bristol-communal-modular/basic-theremin/build/parts-guide.png

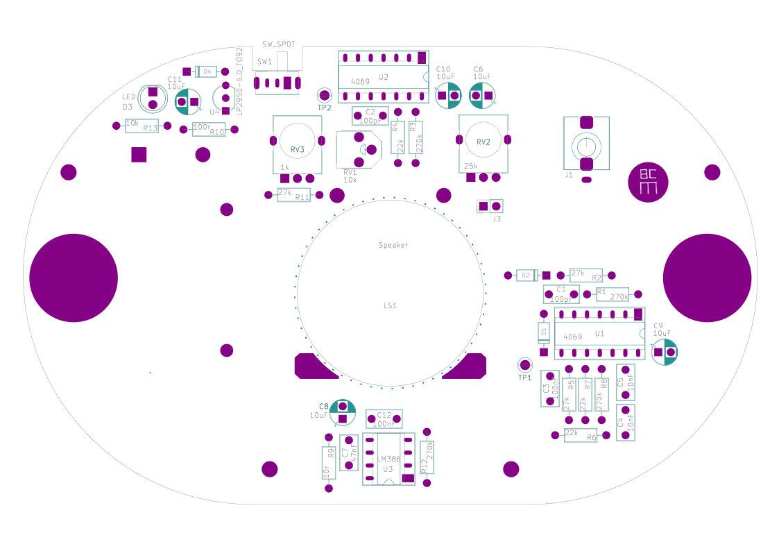
build/parts-guide.png
