bristol-communal-modular/basic-theremin/build/clara-bom.pdf

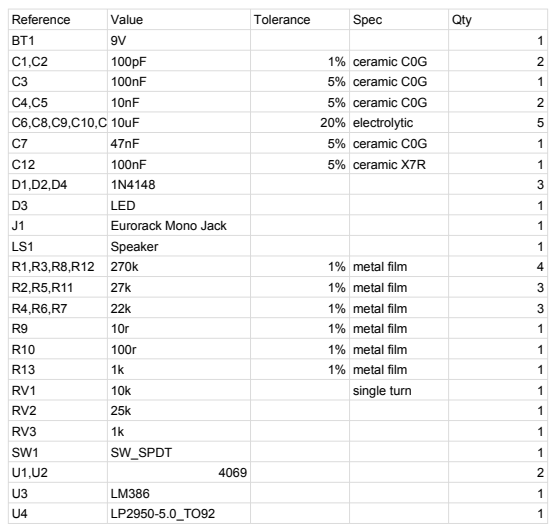
[picture p2: page 1]
