bristol-communal-modular/basic-theremin/build/schematic.pdf

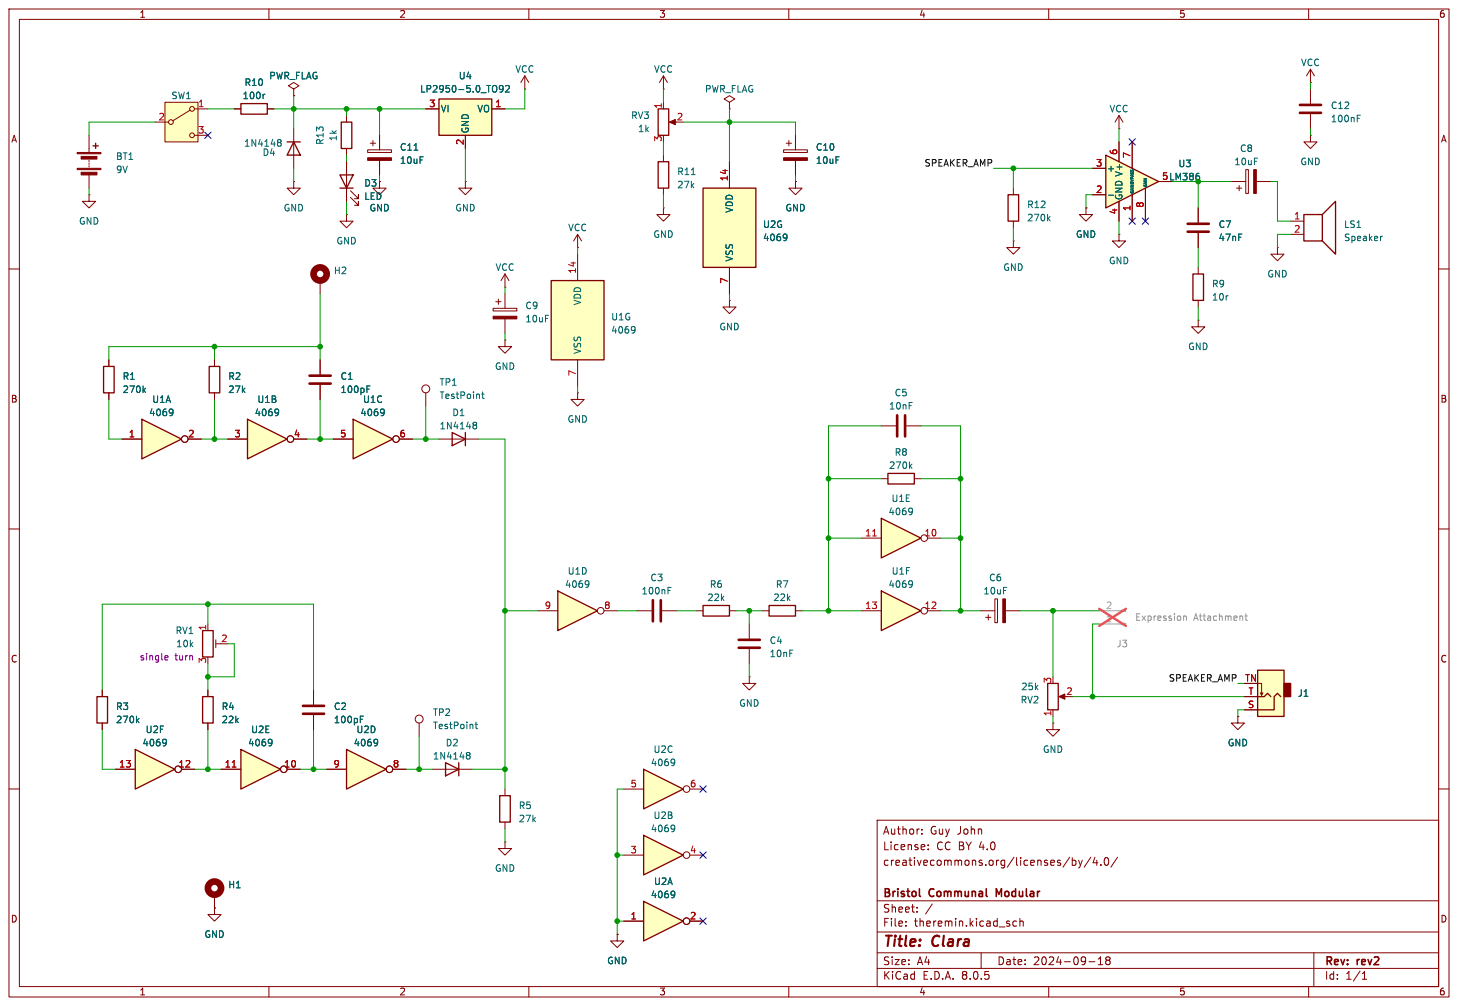
[picture p3: page 1]
