bristol-communal-modular/basic-theremin/kicad/theremin.kicad_pcb

## KiCad design kicad/theremin.kicad_pcb (2024-09-22)

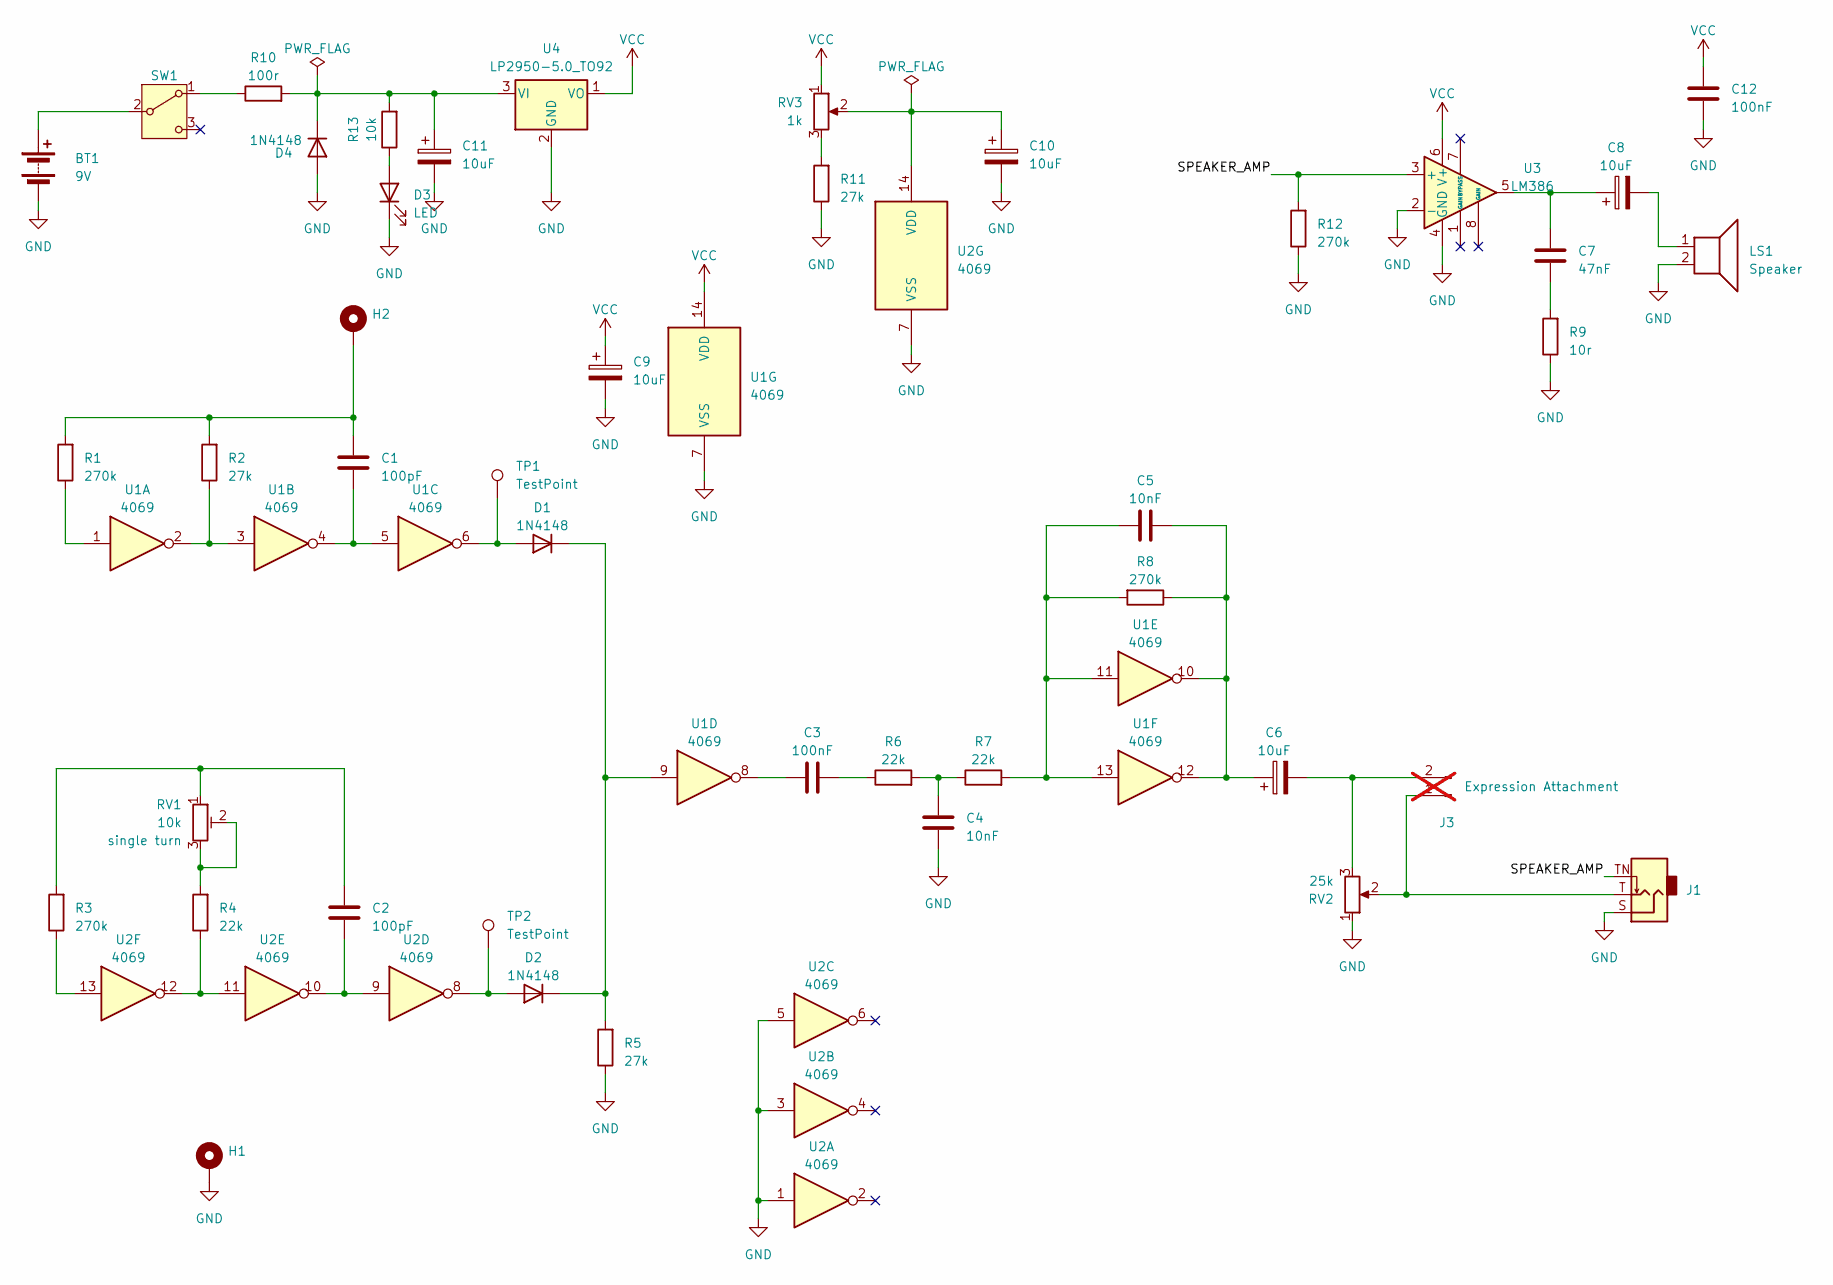
[picture p4: schematic theremin.kicad_sch, Clara]

Parts:
BT1: 9V; BatteryHolder_Eagle_12BH611-GRMODDEDBYROBIN
C1, C2: 100pF; C_Rect_L7.0mm_W3.5mm_P5.00mm; Tolerance 1%
C3, C12: 100nF; C_Rect_L7.0mm_W3.5mm_P5.00mm; Tolerance 5%
C4, C5: 10nF; C_Rect_L7.0mm_W3.5mm_P5.00mm; Tolerance 5%
C6, C8, C9, C10, C11: 10uF; CP_Radial_D5.0mm_P2.50mm; Tolerance 20%; Voltage 50v
C7: 47nF; C_Rect_L7.0mm_W3.5mm_P5.00mm; Tolerance 5%
D1, D2, D4: 1N4148; D_DO-35_SOD27_P7.62mm_Horizontal
D3: LED; LED_D5.0mm
H1, H2: MountingHole_Pad; crocclipcircleee
J1: Eurorack Mono Jack; Jack_3.5mm_QingPu_WQP-PJ398SM_Vertical; mpn WQP-WQP518MA
J3: Expression Attachment; PinHeader_1x02_P2.54mm_Vertical; not fitted
LS1: Speaker; 40mmSpeakerdropin
R1, R3, R8, R12: 270k; R_Axial_DIN0207_L6.3mm_D2.5mm_P10.16mm_Horizontal; Tolerance 1%
R2, R5, R11: 27k; R_Axial_DIN0207_L6.3mm_D2.5mm_P10.16mm_Horizontal; Tolerance 1%
R4, R6, R7: 22k; R_Axial_DIN0207_L6.3mm_D2.5mm_P10.16mm_Horizontal; Tolerance 1%
R9: 10r; R_Axial_DIN0207_L6.3mm_D2.5mm_P10.16mm_Horizontal; Tolerance 1%
R10: 100r; R_Axial_DIN0207_L6.3mm_D2.5mm_P10.16mm_Horizontal; Tolerance 1%
R13: 10k; R_Axial_DIN0207_L6.3mm_D2.5mm_P10.16mm_Horizontal; Tolerance 1%
RV1: 10k; Potentiometer_THT_Bourns_3306P_Vertical
RV2: 25k; Potentiometer_Alpha_RD901F-40-00D_Single_Vertical
RV3: 1k; Potentiometer_Alpha_RD901F-40-00D_Single_Vertical
SW1: SW_SPDT; SW_Slide_SPDT_Angled_CK_OS102011MA1Q
TP1, TP2: TestPoint; TestPoint_Loop_D2.50mm_Drill1.0mm_LowProfile
U1, U2: 4069; DIP-14_W7.62mm_Socket_LongPads
U3: LM386; DIP-8_W7.62mm_Socket_LongPads
U4: LP2950-5.0_TO92; TO-92_Inline_Wide

Connections:
/SPEAKER_AMP: J1.TN, R12.2, U3.3 (+)
GND: BT1.2 (-), C4.1, C9.2, C10.2, C11.2, C12.2, D3.1 (K), D4.2 (A), H1.1, J1.S, LS1.2, R5.1, R9.1, R11.1, R12.1, RV2.1, U1.7 (VSS), U2.1, U2.3, U2.5, U2.7 (VSS), U3.2 (-), U3.4 (GND), U4.2 (GND)
unnamed: BT1.1 (+), SW1.2 (B)
unnamed: C1.1, U1.4, U1.5
unnamed: C1.2, H2.1, R1.2, R2.2
unnamed: C2.1, U2.9, U2.10
unnamed: C2.2, R3.2, RV1.1
unnamed: C3.1, U1.8
unnamed: C3.2, R6.1
unnamed: C4.2, R6.2, R7.1
unnamed: C5.1, C6.1, R8.1, U1.10, U1.12
unnamed: C5.2, R7.2, R8.2, U1.11, U1.13
unnamed: C7.1, R9.2
unnamed: C7.2, C8.1, U3.5
unnamed: C8.2, LS1.1
unnamed: D1.2 (A), TP1.1, U1.6
unnamed: D1.1 (K), D2.1 (K), R5.2, U1.9
unnamed: D2.2 (A), TP2.1, U2.8
unnamed: D3.2 (A), R13.1
unnamed: C11.1, D4.1 (K), R10.2, R13.2, U4.3 (VI)
unnamed: J1.T, J3.1, RV2.2
unnamed: C6.2, J3.2, RV2.3
unnamed: R1.1, U1.1
unnamed: R2.1, U1.2, U1.3
unnamed: R3.1, U2.13
unnamed: R4.1, U2.11, U2.12
unnamed: R4.2, RV1.2, RV1.3
unnamed: R11.2, RV3.3
unnamed: R10.1, SW1.1 (A)
unnamed: C10.1, RV3.2, U2.14 (VDD)
VCC: C9.1, C12.1, RV3.1, U1.14 (VDD), U3.6 (V+), U4.1 (VO)

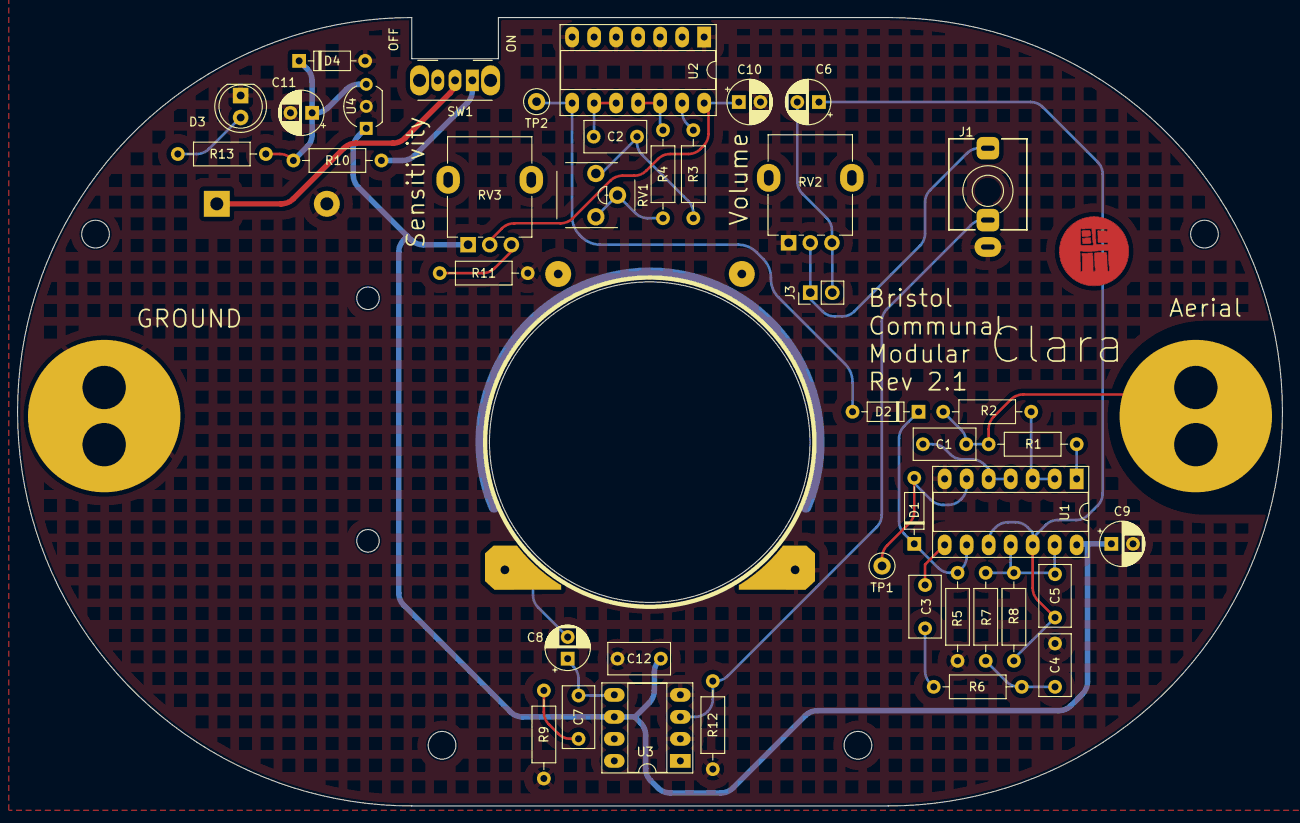
[picture p5: board theremin.kicad_pcb from above]

Board: 2 copper layers, 146.0 x 91.0 mm, 49 parts (1 on the bottom side), 31 nets.

Other parts of the board:
EF**: MountingHole_3.2mm_M3
EF**#2, EF**#3, EF**#4: MountingHole_3.2mm_M3
