bristol-communal-modular/basic-theremin/(commit log)

2024-06-19 Updating with new footprints and some tweaks
    [theremin.kicad_pcb, theremin.kicad_sch]
2024-06-30 Now with extra pretty!
    Added the updated prettiefied version of the theremin files and added some quality of life features such as battery clip, crocodile clip friendly connectors, built in speaker & a power switch
    [theremin-B_Cu.gbl, theremin-B_Mask.gbs, theremin-B_Silkscreen.gbo, theremin-Edge_Cuts.gm1, theremin-F_Cu.gtl, theremin-F_Mask.gts, theremin-F_Silkscreen.gto, theremin-NPTH.drl]
2024-07-02 Tidying things up a bit
    [theremin-B_Cu.gbl, theremin-B_Mask.gbs, theremin-B_Silkscreen.gbo, theremin-Edge_Cuts.gm1, theremin-F_Cu.gtl, theremin-F_Mask.gts, theremin-F_Silkscreen.gto, theremin-NPTH.drl]
2024-07-03 More updates
    [theremin-B_Cu.gbl, theremin-B_Mask.gbs, theremin-B_Silkscreen.gbo, theremin-Edge_Cuts.gm1, theremin-F_Cu.gtl, theremin-F_Mask.gts, theremin-F_Silkscreen.gto, theremin-NPTH.drl]
2024-07-03 More tweaks
    [theremin.kicad_sch]
2024-07-03 Regenerating gerbers
    [theremin-B_Cu.gbl, theremin-B_Mask.gbs, theremin-B_Silkscreen.gbo, theremin-Edge_Cuts.gm1, theremin-F_Cu.gtl, theremin-F_Mask.gts, theremin-F_Silkscreen.gto, theremin-NPTH.drl]
2024-07-04 Final tweaks to make sure the front plate holes are on grid
    [theremin-B_Cu.gbl, theremin-B_Mask.gbs, theremin-B_Silkscreen.gbo, theremin-Edge_Cuts.gm1, theremin-F_Cu.gtl, theremin-F_Mask.gts, theremin-F_Silkscreen.gto, theremin-NPTH.drl]
2024-07-22 Adding interactive bom
2024-09-18 Fixing issues with layout
    * Making sure speaker fixing copper isn't covered on speaker footprint
    * Adding two more plated holes to make fixing speaker easier
    * Making holes for battery holder smaller so easier to solder
    * Adding another mounting hole for faceplate
    * Tweaking value and reference text placements
    [theremin.kicad_pcb, theremin.kicad_sch]
2024-09-18 Adding schematic page text
    [theremin.kicad_sch]
2024-09-18 Adding updated gerbers
    [theremin-B_Cu.gbl, theremin-B_Mask.gbs, theremin-B_Silkscreen.gbo, theremin-Edge_Cuts.gm1, theremin-F_Cu.gtl, theremin-F_Mask.gts, theremin-F_Silkscreen.gto, theremin-NPTH.drl]
2024-09-18 Adding schematic to build directory
2024-09-18 Updating interactive bom
2024-09-18 Adding testpoints at output of oscillators
    [theremin-B_Cu.gbl, theremin-B_Mask.gbs, theremin-B_Silkscreen.gbo, theremin-Edge_Cuts.gm1, theremin-F_Cu.gtl, theremin-F_Mask.gts, theremin-F_Silkscreen.gto, theremin-NPTH.drl]
2024-09-18 Updating schematic
2024-09-18 Creating BOM as csv and pdf files
    [clara-bom.csv]
2024-09-22 Updating correct LED resistor value
    [theremin.kicad_pcb, theremin.kicad_sch]
