bristol-communal-modular/basic-theremin/(notices)

Notices in the files:
kicad/theremin.kicad_sch:
creativecommons.org/licenses/by/4.0
License: CC BY 4.0
